ushicow/iieaux/KiCad/IIeAux.kicad_pcb

## KiCad design KiCad/IIeAux.kicad_pcb (2026-03-03)

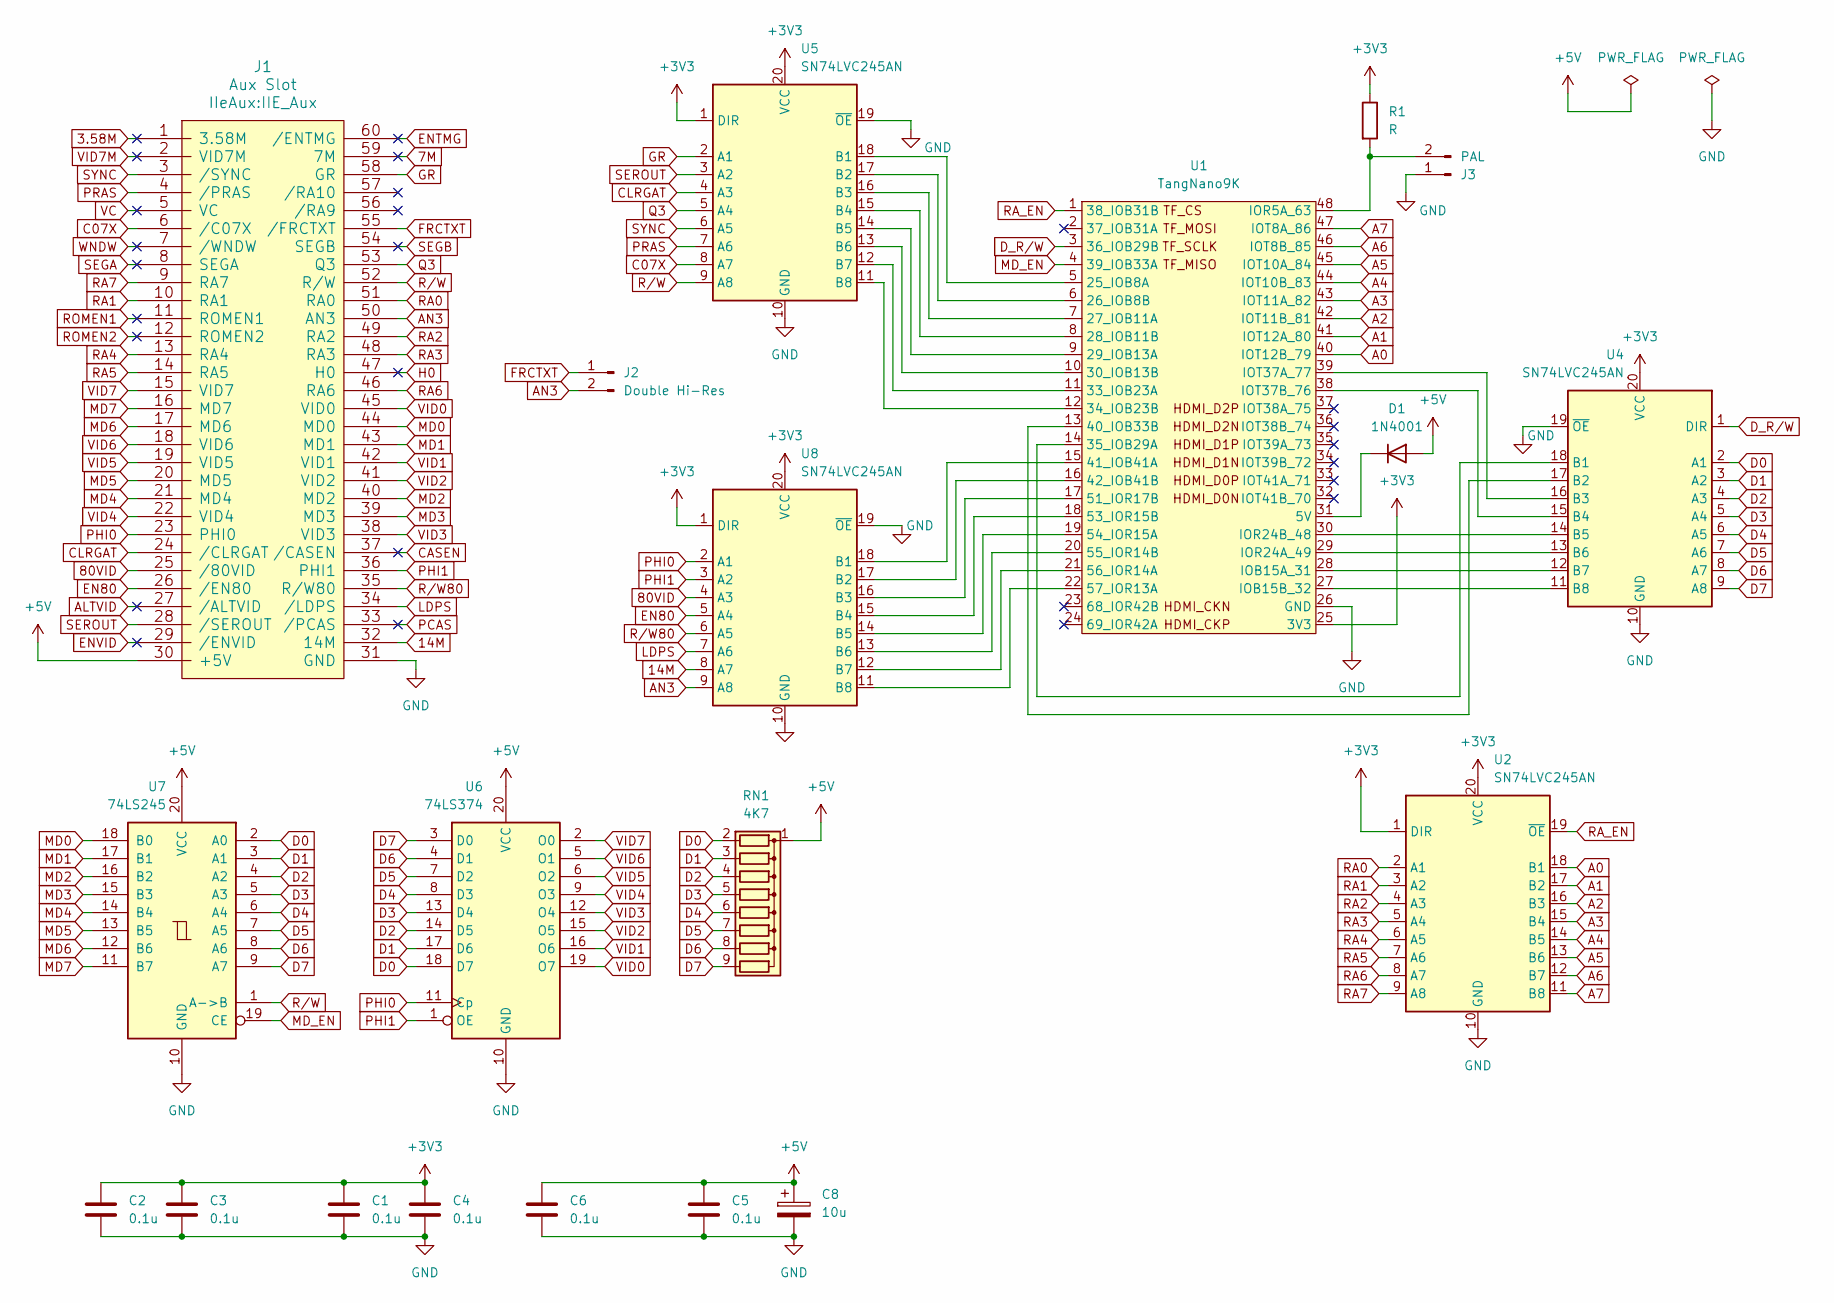
[picture p1: schematic IIeAux.kicad_sch]

Parts:
C1, C2, C3, C4, C5, C6: 0.1u; C_Disc_D4.3mm_W1.9mm_P5.08mm
C8: 10u; CP_Radial_D5.0mm_P2.00mm
D1: 1N4001; D_DO-41_SOD81_P10.16mm_Horizontal
J1: Aux Slot; IIE_Aux
J2: Double Hi-Res; PinHeader_1x02_P2.54mm_Horizontal
J3: PAL; PinHeader_1x02_P2.54mm_Horizontal
R1: R; R_Axial_DIN0207_L6.3mm_D2.5mm_P10.16mm_Horizontal
RN1: 4K7; R_Array_SIP9
U1: TangNano9K
U2, U4, U5, U8: SN74LVC245AN; DIP-20_W7.62mm_Socket
U6: 74LS374; DIP-20_W7.62mm_Socket
U7: 74LS245; DIP-20_W7.62mm_Socket

Connections:
3.58M: J1.1 (3.58M)
7M: J1.59 (7M)
14M: J1.32 (14M), U8.8 (A7)
80VID: J1.25 (/80VID), U8.4 (A3)
+3V3: C1.1, C2.1, C3.1, C4.1, R1.1, U1.25 (3V3), U2.1 (DIR), U2.20 (VCC), U4.20 (VCC), U5.1 (DIR), U5.20 (VCC), U8.1 (DIR), U8.20 (VCC); also elsewhere on the board
+5V: C5.1, C6.1, C8.1, D1.2 (A), J1.30 (+5V), RN1.1 (common), U6.20 (VCC), U7.20 (VCC)
A0: U1.40 (IOT12B_79), U2.18 (B1); also elsewhere on the board
A1: U1.41 (IOT12A_80), U2.17 (B2); also elsewhere on the board
A2: U1.42 (IOT11B_81), U2.16 (B3); also elsewhere on the board
A3: U1.43 (IOT11A_82), U2.15 (B4); also elsewhere on the board
A4: U1.44 (IOT10B_83), U2.14 (B5); also elsewhere on the board
A5: U1.45 (IOT10A_84), U2.13 (B6); also elsewhere on the board
A6: U1.46 (IOT8B_85), U2.12 (B7); also elsewhere on the board
A7: U1.47 (IOT8A_86), U2.11 (B8); also elsewhere on the board
ALTVID: J1.27 (/ALTVID)
AN3: J1.50 (AN3), J2.2, U8.9 (A8)
C07X: J1.6 (/C07X), U5.8 (A7)
CASEN: J1.37 (/CASEN)
D0: RN1.2 (R1), U4.2 (A1), U6.18 (D7), U7.2 (A0)
D1: RN1.3 (R2), U4.3 (A2), U6.17 (D6), U7.3 (A1)
D2: RN1.4 (R3), U4.4 (A3), U6.14 (D5), U7.4 (A2)
D3: RN1.5 (R4), U4.5 (A4), U6.13 (D4), U7.5 (A3)
D4: RN1.6 (R5), U4.6 (A5), U6.8 (D3), U7.6 (A4)
D5: RN1.7 (R6), U4.7 (A6), U6.7 (D2), U7.7 (A5)
D6: RN1.8 (R7), U4.8 (A7), U6.4 (D1), U7.8 (A6)
D7: RN1.9 (R8), U4.9 (A8), U6.3 (D0), U7.9 (A7)
D_R/W: U1.3 (36_IOB29B), U4.1 (DIR)
EN80: J1.26 (/EN80), U8.5 (A4)
ENTMG: J1.60 (/ENTMG)
ENVID: J1.29 (/ENVID)
FRCTXT: J1.55 (/FRCTXT), J2.1
GND: C1.2, C2.2, C3.2, C4.2, C5.2, C6.2, C8.2, J1.31 (GND), J3.1, U1.26 (GND), U2.10 (GND), U4.10 (GND), U4.19 (~OE), U5.10 (GND), U5.19 (~OE), U6.10 (GND), U7.10 (GND), U8.10 (GND), U8.19 (~OE); also elsewhere on the board
GR: J1.58 (GR), U5.2 (A1)
H0: J1.47 (H0)
LDPS: J1.34 (/LDPS), U8.7 (A6)
MD0: J1.44 (MD0), U7.18 (B0)
MD1: J1.43 (MD1), U7.17 (B1)
MD2: J1.40 (MD2), U7.16 (B2)
MD3: J1.39 (MD3), U7.15 (B3)
MD4: J1.21 (MD4), U7.14 (B4)
MD5: J1.20 (MD5), U7.13 (B5)
MD6: J1.17 (MD6), U7.12 (B6)
MD7: J1.16 (MD7), U7.11 (B7)
MD_EN: U1.4 (39_IOB33A), U7.19 (CE)
unnamed: D1.1 (K), U1.31 (5V)
unnamed: J3.2, R1.2, U1.48 (IOR5A_63)
unnamed: U1.5 (25_IOB8A), U5.18 (B1)
unnamed: U1.6 (26_IOB8B), U5.17 (B2)
unnamed: U1.7 (27_IOB11A), U5.16 (B3)
unnamed: U1.8 (28_IOB11B), U5.15 (B4)
unnamed: U1.9 (29_IOB13A), U5.14 (B5)
unnamed: U1.10 (30_IOB13B), U5.13 (B6)
unnamed: U1.11 (33_IOB23A), U5.12 (B7)
unnamed: U1.12 (34_IOB23B), U5.11 (B8)
unnamed: U1.14 (35_IOB29A), U4.18 (B1)
unnamed: U1.13 (40_IOB33B), U4.17 (B2)
unnamed: U1.15 (41_IOB41A), U8.18 (B1)
unnamed: U1.16 (42_IOB41B), U8.17 (B2)
unnamed: U1.17 (51_IOR17B), U8.16 (B3)
unnamed: U1.18 (53_IOR15B), U8.15 (B4)
unnamed: U1.19 (54_IOR15A), U8.14 (B5)
unnamed: U1.20 (55_IOR14B), U8.13 (B6)
unnamed: U1.21 (56_IOR14A), U8.12 (B7)
unnamed: U1.22 (57_IOR13A), U8.11 (B8)
unnamed: U1.28 (IOB15A_31), U4.12 (B7)
unnamed: U1.27 (IOB15B_32), U4.11 (B8)
unnamed: U1.29 (IOR24A_49), U4.13 (B6)
unnamed: U1.30 (IOR24B_48), U4.14 (B5)
unnamed: U1.39 (IOT37A_77), U4.16 (B3)
unnamed: U1.38 (IOT37B_76), U4.15 (B4)
PCAS: J1.33 (/PCAS)
PHI0: J1.23 (PHI0), U6.11 (Cp), U8.2 (A1)
PHI1: J1.36 (PHI1), U6.1 (OE), U8.3 (A2)
PRAS: J1.4 (/PRAS), U5.7 (A6)
Q3: J1.53 (Q3), U5.5 (A4)
RA0: J1.51 (RA0), U2.2 (A1)
RA1: J1.10 (RA1), U2.3 (A2)
RA2: J1.49 (RA2), U2.4 (A3)
RA3: J1.48 (RA3), U2.5 (A4)
RA4: J1.13 (RA4), U2.6 (A5)
RA5: J1.14 (RA5), U2.7 (A6)
RA6: J1.46 (RA6), U2.8 (A7)
RA7: J1.9 (RA7), U2.9 (A8)
RA_EN: U1.1 (38_IOB31B), U2.19 (~OE)
ROMEN1: J1.11 (ROMEN1)
ROMEN2: J1.12 (ROMEN2)
R/W: J1.52 (R/W), U5.9 (A8), U7.1 (A->B)
R/W80: J1.35 (R/W80), U8.6 (A5)
SEGA: J1.8 (SEGA)
SEGB: J1.54 (SEGB)
SYNC: J1.3 (/SYNC), U5.6 (A5)
VC: J1.5 (VC)
VID0: J1.45 (VID0), U6.19 (O7); also elsewhere on the board
VID1: J1.42 (VID1), U6.16 (O6); also elsewhere on the board
VID2: J1.41 (VID2), U6.15 (O5); also elsewhere on the board
VID3: J1.38 (VID3), U6.12 (O4); also elsewhere on the board
VID4: J1.22 (VID4), U6.9 (O3); also elsewhere on the board
VID5: J1.19 (VID5), U6.6 (O2); also elsewhere on the board
VID6: J1.18 (VID6), U6.5 (O1); also elsewhere on the board
VID7: J1.15 (VID7), U6.2 (O0); also elsewhere on the board
VID7M: J1.2 (VID7M)
VID_EN: U1.2 (37_IOB31A); also elsewhere on the board
WNDW: J1.7 (/WNDW)

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
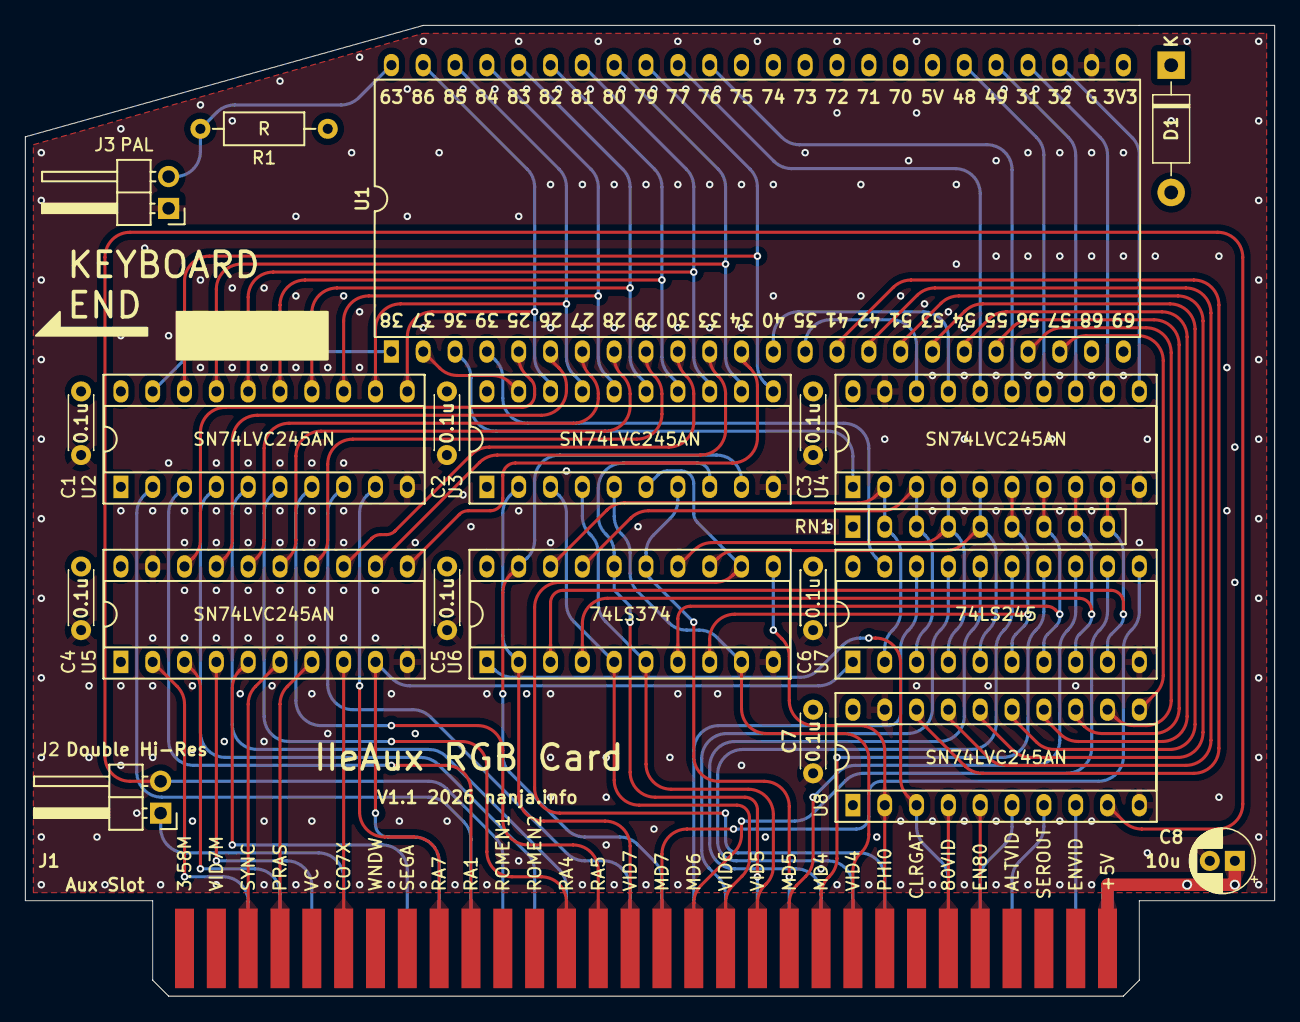
[picture p2: board IIeAux.kicad_pcb from above]

Board: 4 copper layers, 99.7 x 77.5 mm, 22 parts (0 on the bottom side), 90 nets.

Other parts of the board:
C7: 0.1u; C_Disc_D4.3mm_W1.9mm_P5.08mm
U3: SN74LVC245AN; DIP-20_W7.62mm_Socket

Their connections:
+3V3: C7.1, U3.1 (DIR), U3.20 (VCC); also elsewhere on the board
A0: U3.11 (B8); also elsewhere on the board
A1: U3.12 (B7); also elsewhere on the board
A2: U3.13 (B6); also elsewhere on the board
A3: U3.14 (B5); also elsewhere on the board
A4: U3.15 (B4); also elsewhere on the board
A5: U3.16 (B3); also elsewhere on the board
A6: U3.17 (B2); also elsewhere on the board
A7: U3.18 (B1); also elsewhere on the board
GND: C7.2, U3.10 (GND); also elsewhere on the board
VID0: U3.9 (A8); also elsewhere on the board
VID1: U3.8 (A7); also elsewhere on the board
VID2: U3.7 (A6); also elsewhere on the board
VID3: U3.6 (A5); also elsewhere on the board
VID4: U3.5 (A4); also elsewhere on the board
VID5: U3.4 (A3); also elsewhere on the board
VID6: U3.3 (A2); also elsewhere on the board
VID7: U3.2 (A1); also elsewhere on the board
VID_EN: U3.19 (~OE); also elsewhere on the board
