ushicow/iieaux/Gowin/src/gowin_rpll/gowin_rpll_tmp.v

//Copyright (C)2014-2025 Gowin Semiconductor Corporation.
//All rights reserved.
//File Title: Template file for instantiation
//Tool Version: V1.9.12.01
//IP Version: 1.0
//Part Number: GW1NR-LV9QN88PC6/I5
//Device: GW1NR-9
//Device Version: C
//Created Time: Mon Apr  6 20:31:06 2026

//Change the instance name and port connections to the signal names
//--------Copy here to design--------

    Gowin_rPLL your_instance_name(
        .clkout(clkout), //output clkout
        .lock(lock), //output lock
        .clkoutp(clkoutp), //output clkoutp
        .clkin(clkin) //input clkin
    );

//--------Copy end-------------------
