ushicow/iieaux/Gowin/src/dvi_tx/dvi_tx_tmp.v

//Copyright (C)2014-2025 Gowin Semiconductor Corporation.
//All rights reserved.
//File Title: Template file for instantiation
//Tool Version: V1.9.12.01
//IP Version: 3.0
//Part Number: GW1NR-LV9QN88PC6/I5
//Device: GW1NR-9
//Device Version: C
//Created Time: Mon Mar 23 14:06:10 2026

//Change the instance name and port connections to the signal names
//--------Copy here to design--------

	DVI_TX_Top your_instance_name(
		.I_rst_n(I_rst_n), //input I_rst_n
		.I_serial_clk(I_serial_clk), //input I_serial_clk
		.I_rgb_clk(I_rgb_clk), //input I_rgb_clk
		.I_rgb_vs(I_rgb_vs), //input I_rgb_vs
		.I_rgb_hs(I_rgb_hs), //input I_rgb_hs
		.I_rgb_de(I_rgb_de), //input I_rgb_de
		.I_rgb_r(I_rgb_r), //input [7:0] I_rgb_r
		.I_rgb_g(I_rgb_g), //input [7:0] I_rgb_g
		.I_rgb_b(I_rgb_b), //input [7:0] I_rgb_b
		.O_tmds_clk_p(O_tmds_clk_p), //output O_tmds_clk_p
		.O_tmds_clk_n(O_tmds_clk_n), //output O_tmds_clk_n
		.O_tmds_data_p(O_tmds_data_p), //output [2:0] O_tmds_data_p
		.O_tmds_data_n(O_tmds_data_n) //output [2:0] O_tmds_data_n
	);

//--------Copy end-------------------
