ushicow/iieaux/(commit log)

2026-03-03 PCB V1.1
    [IIeAux.kicad_pcb, IIeAux.kicad_sch, IIeAux1.kicad_pcb]
2026-03-06 Use SEROUT signal
    [IIeAux.kicad_sch]
2026-03-07 80 Colmun Text
    [IIeAux.kicad_pcb, IIeAux.kicad_sch, IIeAux1.kicad_pcb]
2026-03-11 DVI output 560 x 192
    [IIeAux.kicad_sch]
2026-03-23 frame buffer
2026-03-28 extended 64K RAM
    [IIeAux.kicad_pcb, IIeAux.kicad_sch]
2026-04-26 correct data bus timing
    [IIeAux.kicad_sch]
2026-05-01 PCB V2.0
    [IIeAux.kicad_sch]
2026-05-14 firmware for PCB V2.0
2026-05-23 mono/color switch
